saramic/green-brain/README.md

# Green Brain

Element 14 Design Challenge
- [https://community.element14.com/challenges-projects/design-challenges/on-the-line](
  https://community.element14.com/challenges-projects/design-challenges/on-the-line)

**GreenBrain**: An industrial distributed control platform for precision greenhouse
automation powered by an **Arduino UNO Q**

## Blog

[https://saramic.github.io/green-brain/](
https://saramic.github.io/green-brain/)
