saramic/green-brain/(commit log)

2026-04-21 A first blog post DRAFT - CAN bus
2026-05-01 Arduino to DHT11 temp/humidity
2026-05-04 Basic CAN bus between 2 nodes RX & TX
2026-05-07 Wrap up with video and new Arduino upload
2026-05-11 Watched a bunch of LabView and Arduino videos
2026-05-30 On UNO Q arduino-app-cli app new green-brain
2026-05-30 LED ON/OFF via web page
2026-05-30 App for CAN bus MCP2515
2026-05-30 Switch from polling to Server-side events
2026-05-31 Add a simple graph of temperature and humidity
2026-06-20 Back to a cannon after some testing
    seems that the servos move to right and up due to noise from the pump on
    a common ground connection? as even the power is not connected. Maybe a
    diode would be enough to sort this out.
    [main.cpp]
2026-06-21 Retries, errors and timing offset for nodes
    [main.cpp, sketch.ino]
2026-06-21 Blog post on debugging collissions and SPI
